Shacharito/Final-Project/docs/architecture/ARCHITECTURE_DIAGRAM.md

# Firmware Architecture Diagram

## Boot Sequence Flow (Robust)

```
┌─────────────────────────────────────────────────────────┐
│                    DEVICE POWERS ON                      │
└──────────────────────┬──────────────────────────────────┘
                       │
                       ▼
        ┌──────────────────────────────────┐
        │   Initialize Serial (460800 baud)│
        │   Display Startup Banner         │
        │   Increment boot counter         │
        └──────────────┬───────────────────┘
                       │
                       ▼
        ┌──────────────────────────────────┐
        │      WiFi Initialization         │
        │      [CRITICAL - REQUIRED]       │
        └──────────────┬───────────────────┘
                       │
          ┌────────────┴────────────┐
          │                         │
          ▼ (Success)              ▼ (Fail)
      ✅ Connected             ❌ Sleep Now!
          │                         │
          │                    Enter Deep Sleep
          │                    Retry on wake
          │
          ▼
        ┌──────────────────────────────────┐
        │    Hardware Initialization       │
        │    [IMPORTANT - NON-FATAL]       │
        │                                  │
        │  1. Try to init camera           │
        │  2. If fails: Log error          │
        │  3. Mark unavailable             │
        │  4. CONTINUE ANYWAY!             │
        └──────────────┬───────────────────┘
                       │
          ┌────────────┴────────────┐
          │                         │
    ✅ Camera Ready           ⚠️ Camera Failed
     (Inference works)    (Graceful degradation)
          │                         │
          └────────────┬────────────┘
                       │
                       ▼
        ┌──────────────────────────────────┐
        │     WebServer Initialization     │
        │     [ALWAYS WORKS]               │
        │                                  │
        │ Register endpoints:              │
        │  - /run (inference)              │
        │  - /image.jpg                    │
        │  - /get_config                   │
        │  - /set_config                   │
        │  - /sleep                        │
        │  - /health (NEW!)                │
        │  - /diagnose (NEW!)              │
        └──────────────┬───────────────────┘
                       │
                       ▼
        ┌──────────────────────────────────┐
        │      Display Boot Summary        │
        │      Show available endpoints    │
        │      Ready for requests          │
        └──────────────┬───────────────────┘
                       │
                       ▼
        ┌──────────────────────────────────┐
        │      Main Loop (Event-Driven)    │
        │      server.handleClient()       │
        │      Wait for HTTP requests      │
        └──────────────────────────────────┘
```

---

## Error Handling Architecture

```
┌────────────────────────────────────────────────────────┐
│              ERROR HANDLING STRATEGY                    │
└────────────────────────────────────────────────────────┘

LEVEL 1: CRITICAL (Must Succeed)
┌─────────────────────────────────────────────────────┐
│ WiFi Connection                                      │
│ ├─ Success: Continue to next step                  │
│ └─ Fail: Enter deep sleep immediately              │
│          Retry on next wakeup                       │
└─────────────────────────────────────────────────────┘

LEVEL 2: IMPORTANT (Report but Continue)
┌─────────────────────────────────────────────────────┐
│ Camera Initialization                               │
│ ├─ Success: Mark camera_initialized=true           │
│ ├─ Fail: Log error, Mark false, CONTINUE           │
│ │        Device stays online for diagnostics        │
│ └─ Inference requests return 503 error             │
│                                                      │
│ Image Capture                                       │
│ ├─ Success: Use for inference                      │
│ └─ Fail: Report error to client via API            │
│                                                      │
│ Inference Execution                                 │
│ ├─ Success: Return classification results          │
│ └─ Fail: Return 500 with error details             │
└─────────────────────────────────────────────────────┘

LEVEL 3: ADVISORY (Log Only)
┌─────────────────────────────────────────────────────┐
│ Memory Allocation                                    │
│ ├─ Success: Use allocated buffer                   │
│ └─ Fail: Log and return error to client            │
│                                                      │
│ Individual Sensor Errors                            │
│ ├─ Log error                                        │
│ └─ Continue operation                              │
└─────────────────────────────────────────────────────┘
```

---

## API Endpoint Architecture

```
┌──────────────────────────────────────────────────┐
│          HTTP SERVER (Port 80)                   │
└──────────────────────────────────────────────────┘
        │
        ├─────────────────────────────────────────────────┐
        │         INFERENCE ENDPOINTS                     │
        │                                                 │
        ├─→ GET /run                                      │
        │   └─ Run person detection                      │
        │      ├─ Check: camera_initialized?             │
        │      ├─ Try: Capture image                     │
        │      ├─ Try: Run model                         │
        │      └─ Return: Classification or error (503)  │
        │                                                 │
        ├─→ GET /image.jpg                              │
        │   └─ Return: Last JPEG (or 404)                │
        │
        └─────────────────────────────────────────────────┐
        │         CONFIGURATION ENDPOINTS                 │
        │                                                 │
        ├─→ GET /get_config                              │
        │   └─ Return: SSID, thresholds, boot count      │
        │                                                 │
        ├─→ POST /set_config?ssid=X&password=Y           │
        │   └─ Update: WiFi and inference settings       │
        │                                                 │
        ├─→ POST /sleep?duration=60                      │
        │   └─ Action: Enter deep sleep                  │
        │
        └─────────────────────────────────────────────────┐
        │      DIAGNOSTIC ENDPOINTS (NEW!)                │
        │                                                 │
        ├─→ GET /health                                  │
        │   └─ Return: { wifi: bool, camera: bool, ... } │
        │                                                 │
        ├─→ GET /diagnose                                │
        │   └─ Return: { device_info, hardware, memory } │
        │                                                 │
        └─ Both always work - even if camera missing!    │
```

---

## Device State Tracking

```
┌─────────────────────────────────────────────┐
│         DEVICE STATE STRUCTURE              │
├─────────────────────────────────────────────┤
│                                             │
│  wifi_connected: bool                       │
│  └─ Indicates if WiFi is active            │
│                                             │
│  camera_initialized: bool                  │
│  └─ Indicates if camera is ready           │
│                                             │
│  camera_init_error: uint32_t               │
│  └─ Error code if camera failed            │
│     0x20001 = I2C error                    │
│     0x20004 = XCLK error                   │
│     ...                                    │
│                                             │
│  last_capture_error: uint32_t              │
│  └─ Last frame capture error               │
│     1 = camera not initialized             │
│     2 = frame get failed                   │
│     3 = memory allocation failed           │
│                                             │
│  last_inference_ms: uint32_t               │
│  └─ Performance metric (milliseconds)      │
│                                             │
│  uptime_seconds: unsigned long             │
│  └─ Device uptime since boot               │
│                                             │
└─────────────────────────────────────────────┘
        │
        ├─ Updated by: Hardware init
        ├─ Updated by: Each capture attempt
        ├─ Updated by: Each inference
        └─ Reported by: /health, /diagnose
```

---

## Logging Architecture

```
PREFIX        WHERE           WHAT
────────────────────────────────────────────────────
[BOOT]        setup()         Startup information
[INIT]        setup()         Initialization sequence
[WIFI]        WiFi code       WiFi operations
[CAMERA]      Camera code     Camera initialization
[CAPTURE]     Capture code    Frame capture
[API]         Handlers        HTTP requests
[CONFIG]      SetConfig       Configuration changes
[SLEEP]       Sleep code      Sleep operations
[ERROR]       Everywhere      Error conditions

Example output:
[BOOT] Boot count: 5
[INIT] ▶ WiFi Initialization
[INIT] Connecting to 'Amit_wifi' ......
[INIT] ✓ WiFi connected! IP: 172.20.10.2
[INIT] ▶ Hardware Initialization
[INIT] Testing camera...
[CAMERA] ❌ FAILED: 0x20004
[CAMERA] Continuing without camera...
[INIT] ▶ Web Server Setup
[INIT] ✓ Web server started on port 80
```

---

## Recovery Paths

```
Scenario: Camera Not Connected
─────────────────────────────

Boot:
  1. Try camera init
  2. Fails with 0x20004 (XCLK error)
  3. Log error
  4. Mark camera_initialized = false
  5. Continue to webserver

Client detects issue:
  1. Try: GET /run
  2. Receive: 503 "Camera not initialized"
  3. Check: GET /diagnose
  4. See: camera_init_error: 0x20004
  5. Action: Connect camera

After connecting camera:
  1. Power cycle device (or reboot)
  2. Camera init succeeds
  3. Device ready for inference
  4. No code changes needed!

────────────────────────────────────────

Scenario: WiFi Connection Fails
─────────────────────────────

Boot:
  1. Try WiFi connection
  2. Fails after 20 attempts
  3. Log: "WiFi connection failed"
  4. No alternative: Enter deep sleep
  5. Device wakes after sleep_duration_sec
  6. Retries WiFi connection

Why no recovery? WiFi is critical!
  - No local network = can't reach device
  - No way to diagnose remotely
  - Deep sleep is the only option
```

---

## Code Structure Overview

```
firmware/main/main.ino
│
├─ SECTION 1: Configuration & State
│  ├─ WiFi credentials
│  ├─ Thresholds
│  └─ DeviceState struct (tracks what works)
│
├─ SECTION 2: Utility Functions
│  ├─ ei_malloc() - Safe memory allocation
│  ├─ getErrorMessage() - Human-readable errors
│  ├─ getUptimeSeconds() - System metric
│  └─ get_data() - Inference callback
│
├─ SECTION 3: Power Management
│  ├─ goToDeepSleep() - Safe shutdown
│  └─ getWakeupReasonText() - Wake reason
│
├─ SECTION 4: Hardware Init (FAULT TOLERANT)
│  ├─ initCamera() - Non-fatal failures
│  └─ captureImageForModel() - Safe capture
│
├─ SECTION 5: Web Server (ROBUST)
│  ├─ handleRunInference() - With error checks
│  ├─ handleGetImage() - Graceful not found
│  ├─ handleHealth() - Always works NEW!
│  ├─ handleDiagnose() - Always works NEW!
│  └─ ... other handlers ...
│
└─ SECTION 6: Main Runtime
   ├─ setup() - 6-step initialization
   └─ loop() - Event-driven server
```

---

## Next Steps Flowchart

```
                    START HERE
                        │
                        ▼
                ┌────────────────┐
                │ Power cycle    │
                │ device         │
                └────────┬───────┘
                         │
                         ▼
         ┌───────────────────────────────────┐
         │ Compile NEW firmware             │
         │ arduino-cli compile --fqbn ...   │
         └───────────────┬───────────────────┘
                         │
                         ▼
         ┌───────────────────────────────────┐
         │ Upload firmware                  │
         │ arduino-cli upload -p /dev/... │
         └───────────────┬───────────────────┘
                         │
                         ▼
         ┌───────────────────────────────────┐
         │ Test without camera               │
         │ curl /health                      │
         │ curl /diagnose                    │
         └───────────┬───────────────────────┘
                     │
      ┌──────────────┴──────────────┐
      │                             │
    ✅ YES                        ❌ NO
   (camera_ready: false)       (ERROR)
      │                             │
      ▼                             ▼
   ✅ SUCCESS!              Check error code
   Device works              Review connections
   with sensors              Try reboot
      │
      │ (When camera connected)
      ▼
   Power cycle device
   Camera auto-detected
   Ready for inference!
```

---

## Robustness Checklist

```
✅ Fault Tolerance
   ✓ Camera can be missing
   ✓ Device doesn't crash
   ✓ Errors are reported
   ✓ Can continue without sensors

✅ Error Handling  
   ✓ HTTP status codes correct
   ✓ Error details in response
   ✓ All paths tested
   ✓ No undefined behavior

✅ Diagnostics
   ✓ /health endpoint
   ✓ /diagnose endpoint
   ✓ Clear error codes
   ✓ Memory metrics

✅ Code Quality
   ✓ Organized into sections
   ✓ Clear logging
   ✓ Safe memory management
   ✓ Consistent patterns

✅ Documentation
   ✓ API reference
   ✓ Architecture guide
   ✓ Implementation summary
   ✓ Troubleshooting guide
```
