Shacharito/Final-Project/docs/SESSION_NOTES.md

# men_ai_model – Session Notes

> For project goals and status → see [ROADMAP.md](ROADMAP.md)
>
> This file records debug investigations and session-by-session technical notes.

---

## Session 2 — WiFi + Image Quality (June 11, 2026)

### What was accomplished
- Replaced serial image transfer with WiFi HTTP API (serial was corrupted by VirtualBox USB)
- Added `captureDisplayJpeg()`: grabs a **fresh 320×240 frame** at quality-60 after inference
  - Old display image: 96×96 quality-15 = **1.7 KB** (blocky thumbnail, useless)
  - New display image: 320×240 quality-60 = **8.3 KB** (real camera frame, ~5× larger)
- Python client (`men_ai_model.py`) polls HTTP `/run`, fetches `/image.jpg`, saves labeled JPEG
- Solved VM routing: bridged NIC `enp0s8` needs `sudo ip addr/route`; Python `_ensure_route()` auto-heals
- End-to-end working: Press Enter → ESP32 captures+infers → Python saves `YYYYMMDD_label_XX%.jpg`

### Detection result observed
| Sample | person % | no_person % | Inference |
|---|---|---|---|
| 20260611_173812 | **98.4%** | 1.6% | 148ms |

Only 1 sample taken. Need more captures in varied lighting/angles to judge real-world accuracy.

### Key insight
Photo quality is now much better visually, but the **model still crops to 96×96** — real-world accuracy is limited until the model is retrained on images from this exact camera setup. Next step: increase frame size to VGA so the 96×96 crop sees more context.

---

## Session 1 — Root Cause Analysis: Why the Classifier Wasn't Running (June 11, 2026)

---

## Root Cause Analysis — Why the Classifier Wasn't Running

### Context

The project downloads an Edge Impulse person-classifier model for the ESP32-S3 (GOOUUU cam board with 8MB OPI PSRAM). The sketch compiles and uploads without errors, the camera initializes fine, and frames are captured correctly. But every call to `run_classifier()` returned error **-3** (`EI_IMPULSE_TFLITE_ERROR`), meaning TFLite inference failed completely.

---

### Step 1 — First symptom: error -3 with no explanation

The sketch already had a `printEiError()` function that mapped -3 to `"TFLite or inference engine error"`, but gave no detail. We could see the board booting, camera working, and even `get_data` callbacks firing — but `run_classifier()` silently failed every time.

---

### Step 2 — Enabling hidden TFLite error strings

The Edge Impulse library has this in `micro_log.h`:

```cpp
#ifndef EON_COMPILER_RUN
#define TF_LITE_STRIP_ERROR_STRINGS   // ← silences ALL TFLite internal errors
#endif
```

Because `EON_COMPILER_RUN` is not defined (this is a standard TFLite Micro build), `MicroPrintf(...)` becomes a no-op — every internal TFLite error message is stripped out at compile time. This is why the only output was "AllocateTensors() failed" from the high-level wrapper, with no detail below it.

**Fix:** Comment out `TF_LITE_STRIP_ERROR_STRINGS` in `micro_log.h` to enable verbose TFLite logging.

---

### Step 3 — Finding the exact failure message

With error strings enabled, the board printed:

```
Failed to resize buffer. Requested: 258688, available 189916, missing: 68772
AllocateTensors() failed
```

This meant the TFLite Micro arena (memory workspace used to lay out all tensors and scratch buffers) was too small. The model needed **~259KB** inside the arena at peak, but only **~190KB** was available.

---

### Step 4 — Why the arena was too small

The Edge Impulse library defined the arena size in:
```
src/tflite-model/tflite_learn_1013165_3.h
```
as:
```cpp
const size_t tflite_learn_1013165_3_arena_size = 256403;
```

This value is generated by Edge Impulse's profiler — but it appears to have been underestimated for this specific chip/SDK version combination. The actual peak usage during `AllocateTensors()` was ~325–470KB.

Additionally, the default `ei_calloc()` in the library uses `MALLOC_CAP_DEFAULT`, which can allocate from internal RAM (~298KB free at boot) — but TFLite Micro's internal resizing can fail if the allocation pattern doesn't satisfy alignment or contiguity requirements.

---

### The Fixes (both required together)

#### Fix 1 — Force arena allocation into PSRAM

Added to `men_ai_model.ino` (overrides the weak library symbols):

```cpp
void *ei_malloc(size_t size) {
    return heap_caps_malloc(size, MALLOC_CAP_SPIRAM | MALLOC_CAP_8BIT);
}

void *ei_calloc(size_t nitems, size_t size) {
    return heap_caps_calloc(nitems, size, MALLOC_CAP_SPIRAM | MALLOC_CAP_8BIT);
}

void ei_free(void *ptr) {
    free(ptr);
}
```

The board has **8MB PSRAM** free — this guarantees the 700KB arena fits easily.

#### Fix 2 — Increase the arena size

In `~/Arduino/libraries/esp32_person_classifier_inferencing/src/tflite-model/tflite_learn_1013165_3.h`:

```cpp
// Before:
const size_t tflite_learn_1013165_3_arena_size = 256403;

// After:
const size_t tflite_learn_1013165_3_arena_size = 700000;
```

The `--clean` flag was needed when recompiling to force the cached `.o` files to be rebuilt with the new value.

---

### Result after fixes

```
Inference results:
  no_person   :  2.7%
  person      : 97.3%
  Inference time: 147 ms
```

The classifier runs correctly at ~147ms per frame (~7 fps equivalent) using the ESP32-S3's NN accelerator.

---

## What was done this session

### 1. Arduino IDE / arduino-cli setup
- Arduino IDE 2 was already installed as an AppImage at `~/arduino-ide.AppImage`.
- `arduino-cli` was **not** installed as a standalone tool — it was downloaded and placed at `~/.local/bin/arduino-cli` (v1.5.1).
- To use it in any new terminal session, run:
  ```bash
  export PATH="$HOME/.local/bin:$PATH"
  ```
  Or add that line permanently to `~/.bashrc`.

### 2. arduino-cli configuration
- Config file used: `~/.arduinoIDE/arduino-cli.yaml`
- ESP32 board URL already configured:
  ```
  https://raw.githubusercontent.com/espressif/arduino-esp32/gh-pages/package_esp32_index.json
  ```
- Installed cores:
  - `arduino:avr` 1.8.8
  - `esp32:esp32` 3.3.8 (latest available: 3.3.10)

### 3. Libraries
- `esp32_person_classifier_inferencing` 1.0.1 — already installed (Edge Impulse model)
- `object_detection_inferencing` 1.0.3 — already installed

### 4. Sketch compiled
- Sketch: `men_detection_model/men_ai_model/men_ai_model.ino`
- Board: **ESP32-S3** (GOOUUU ESP32-S3 CAM)
- FQBN used:
  ```
  esp32:esp32:esp32s3:PSRAM=opi,FlashSize=4M,PartitionScheme=huge_app,USBMode=hwcdc,UploadMode=default,CPUFreq=240
  ```
- Compile result: **OK** — 35% flash, 10% RAM

### 5. Sketch uploaded
- Board connected via USB through VirtualBox (forwarded as `/dev/ttyUSB0`)
- Upload command:
  ```bash
  export PATH="$HOME/.local/bin:$PATH"
  arduino-cli upload \
    --fqbn "esp32:esp32:esp32s3:PSRAM=opi,FlashSize=4M,PartitionScheme=huge_app,USBMode=hwcdc,UploadMode=default,CPUFreq=240" \
    --port /dev/ttyUSB0 \
    --config-file ~/.arduinoIDE/arduino-cli.yaml \
    "men_detection_model/men_ai_model"
  ```
- Upload result: **OK** — 1,107,120 bytes written, hard reset done.

---

## Next steps / To continue

### Run the Python listener
The Python script reads serial output (predictions + images) from the ESP32:
```bash
cd men_detection_model
python3 men_ai_model.py
```
Make sure `/dev/ttyUSB0` is available and you have permissions:
```bash
sudo usermod -aG dialout $USER   # then log out/in once
```

### To recompile & re-upload (quick reference)
```bash
export PATH="$HOME/.local/bin:$PATH"

# Compile
arduino-cli compile \
  --fqbn "esp32:esp32:esp32s3:PSRAM=opi,FlashSize=4M,PartitionScheme=huge_app,USBMode=hwcdc,UploadMode=default,CPUFreq=240" \
  --config-file ~/.arduinoIDE/arduino-cli.yaml \
  "men_detection_model/men_ai_model"

# Upload (after connecting board)
arduino-cli upload \
  --fqbn "esp32:esp32:esp32s3:PSRAM=opi,FlashSize=4M,PartitionScheme=huge_app,USBMode=hwcdc,UploadMode=default,CPUFreq=240" \
  --port /dev/ttyUSB0 \
  --config-file ~/.arduinoIDE/arduino-cli.yaml \
  "men_detection_model/men_ai_model"
```

### Optional: update ESP32 core to 3.3.10
```bash
export PATH="$HOME/.local/bin:$PATH"
arduino-cli core update-index --config-file ~/.arduinoIDE/arduino-cli.yaml
arduino-cli core upgrade esp32:esp32 --config-file ~/.arduinoIDE/arduino-cli.yaml
```
