Shacharito/Final-Project/Project Report/מצגת אמצע- 3335 (2).pptx

## פתיחה

- שם הפרויקט- זיהוי עצמים בשטח
- מס' הפרוייקט-3335
- מנחה- חזי ניסתאני
- סטודנטים- עמית שרביט ושחר וינברג
- מקום ביצוע- אוניברסיטת תל אביב
- אישור מנחה- חזי ניסתאני

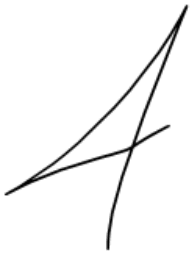
[picture p12: figure]

## נושא הפרויקט

- פיתוח מערכת עצמאית לזיהוי נוכחות בשטח פתוח
- פעילות באזור ללא תשתית חשמל ותקשורת קווית
- צריכת הספק נמוכה ויכולת פעולה ממושכת
  - זמן רצוי לעבודה בשטח- כחצי שנה
- דיוק גבוה
- אינטגרציה של רכיבי מדף חכמים

## דרישות מערכת

- אופן מימוש הפרויקט-אינטגרציה של רכיבי מדף חכמים
- דרישות הפרויקט:
  - זיהוי עצמים עד 30 מ'
  - אחוז זיהוי שווא- קטן מ 10%
  - עמידות בכל תנאי מזג האוויר
  - זמן עבודה בשטח- בהתאם לבדיקות חומרה

## דיאגרמת בלוקים

Field Unit

Battery DC/DC + Charger

WIFI Server

Control Unit

MCU

Computer

PIR Sensor

RADAR Sensor

LIDAR Sensor

Camera

## דיאגרמת בלוקים

- כלל הרכיבים- רכיבי מדף
- אינטגרציה
- אלגוריתמיקה- כדי לקבוע זיהוי

## תוצרי הפרויקט- עד כה

- מפרט דרישות מערכת
- תכן מעגלים ראשוני ושרטוט סכמות
- ביצוע סקר שוק ורכישת רכיבים

## סכמה חשמלית

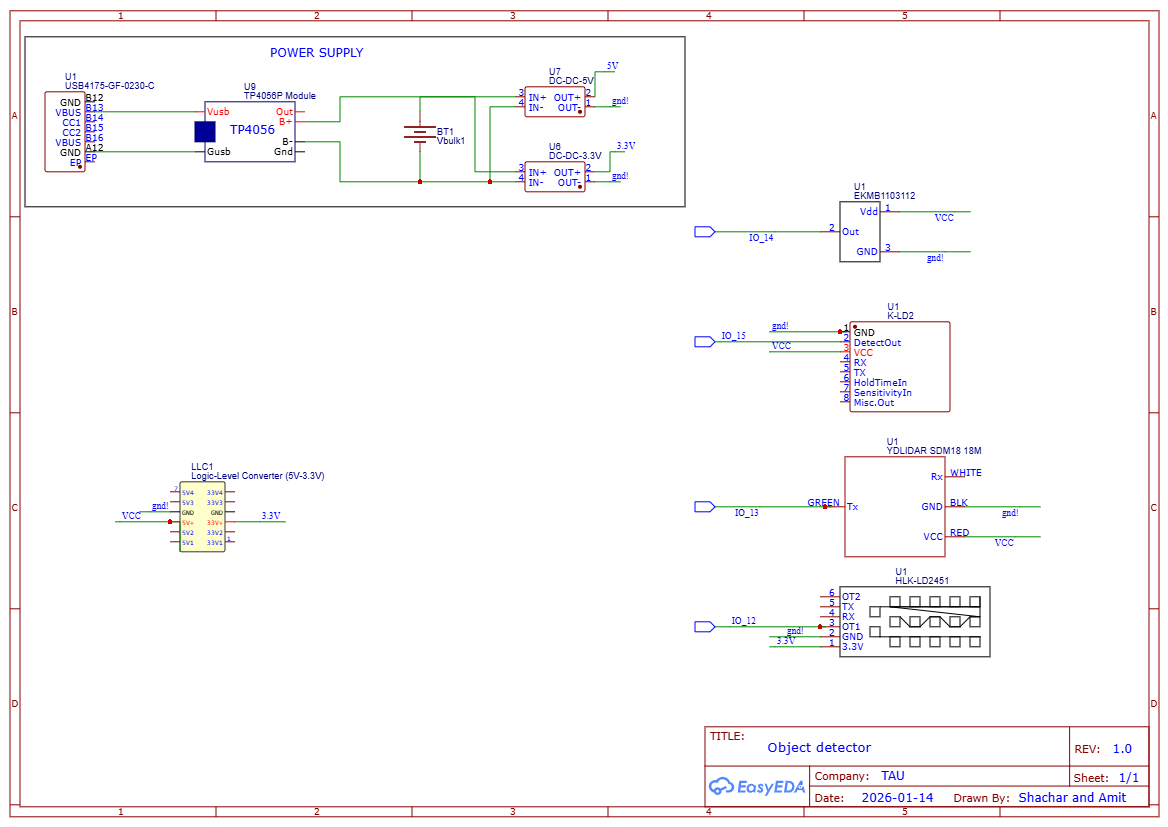
[picture p13: figure]

## סכמה חשמלית

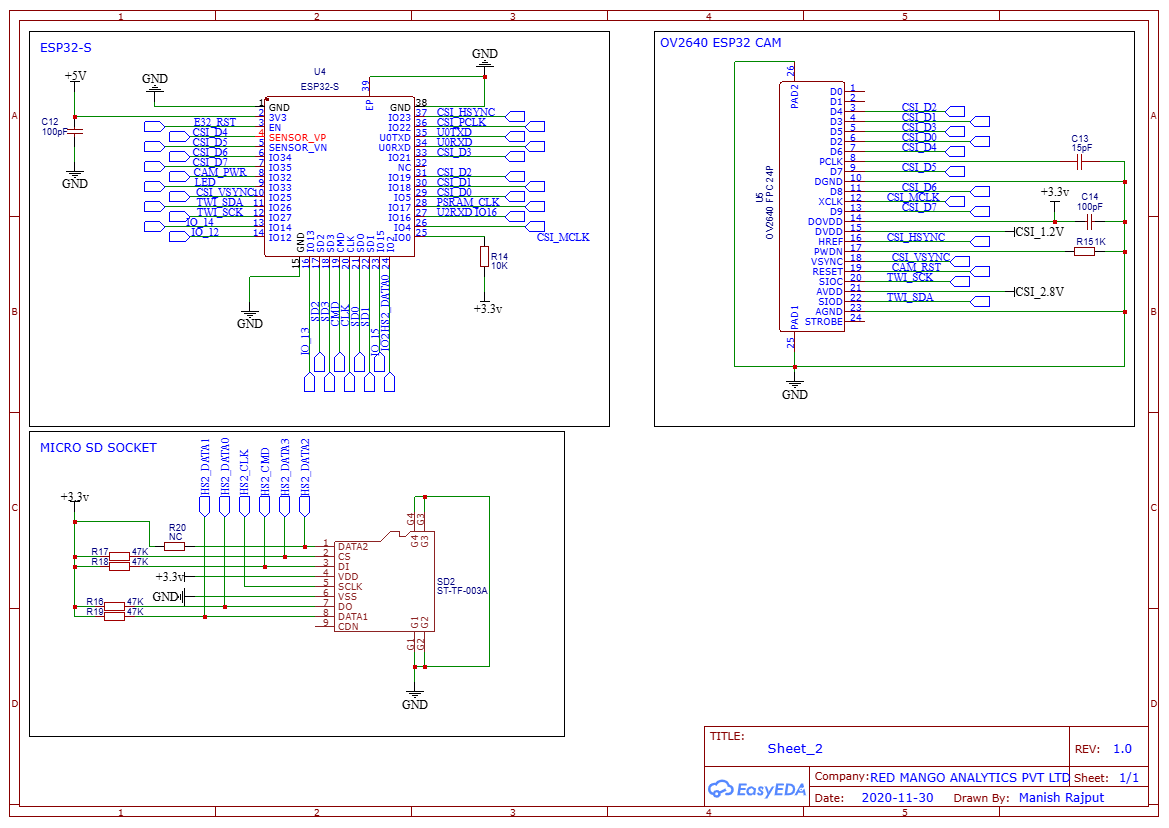
[picture p14: figure]

## סכמה חשמלית

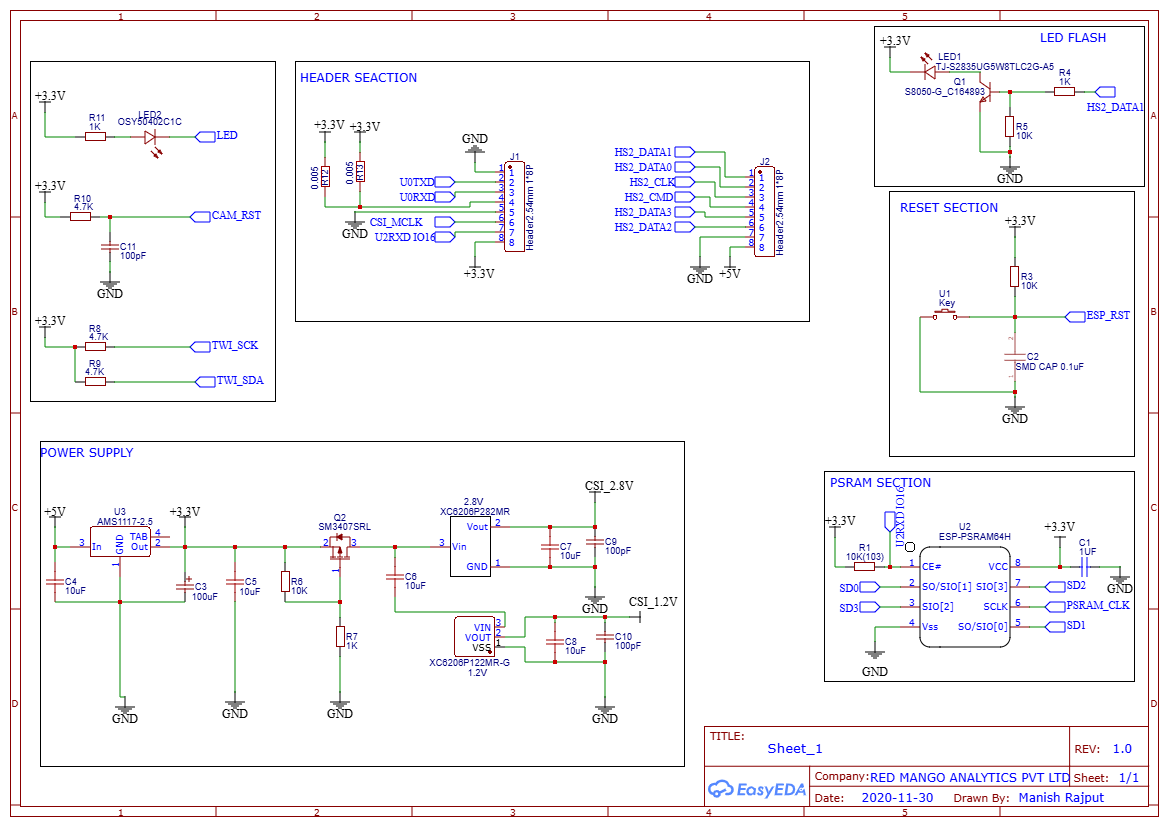
[picture p15: figure]
תמונה שמכילה טקסט, תרשים, תוכנית, מקביל תוכן בינה מלאכותית גנרטיבית עשוי להיות שגוי.

## רכש

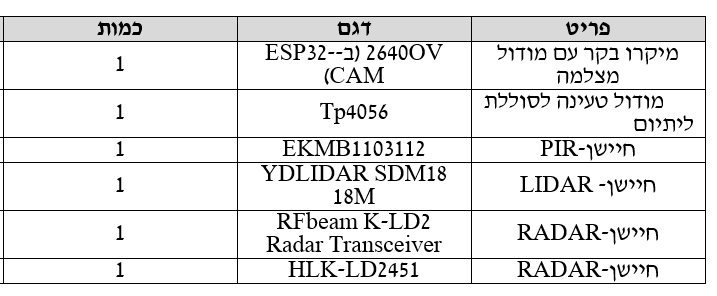
[picture p16: figure]
תמונה שמכילה טקסט, מספר, גופן, צילום מסך תוכן בינה מלאכותית גנרטיבית עשוי להיות שגוי.

## לו"ז מעודכן

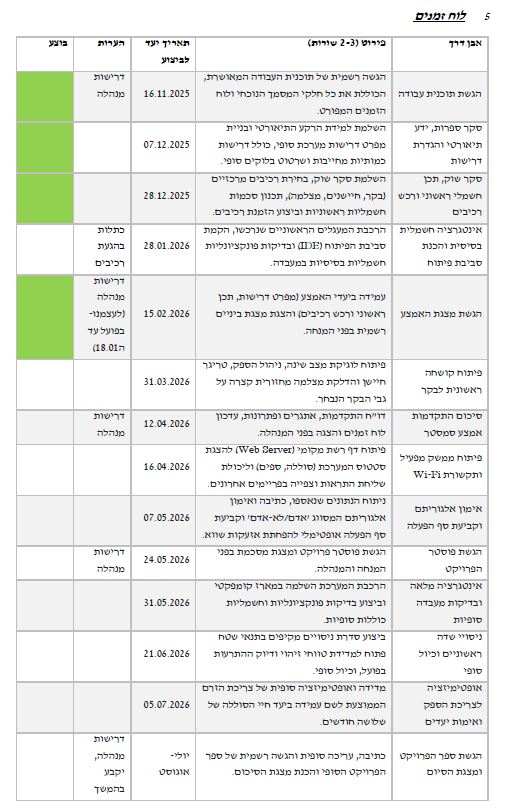
[picture p17: figure]
תמונה שמכילה טקסט, צילום מסך, מסמך, מספר תוכן בינה מלאכותית גנרטיבית עשוי להיות שגוי.
