Shacharito/Final-Project/Project Report/ריכוז נתונים לרכש (1).xlsx

Sheet: כלל הרכיבים
פריט | יצרן | דגם | עקרון פעולה | ממשק נתונים לבקר | ממשק בקרה | צריכת זרם | מצבי שינה | זמן אתחול | קישור למפרט
מיקרו בקר עם תקשורת אלחוטית | Espressif Systems | ESP32 | מתח עבודה טיפוסי 3.3V תדר מעבד עד 240MHz זיכרון פנימי כ-520KB SRAM | WiFi 802.11 b g n Bluetooth BLE UART SPI I2C I2S SDIO GPIO Ethernet MAC | תצורה מלאה דרך תוכנה ו-GPIO אין ממשק בקרה חיצוני ייעודי | מצב עבודה עם WiFi כ-160 עד 260mA מצב קליטה כ-80 עד 90mA Light Sleep כ-0.8mA Deep Sleep עשרות מיקרו אמפר | Active Modem Sleep Light Sleep Deep Sleep Hibernate כולל התעוררות ע"י GPIO טיימר או ULP | אתחול טיפוסי מאות מילישניות תלוי קוד ו-Flash | קישור (https://drive.google.com/drive/folders/1aaki_Vi4lMN0uCIrmu_6FagBYTGURlgb)
מצלמה | OmniVision | OV2640 (ב-ESP32-CAM) | מערך פיקסלים קולט אור → ADC פנימי → ISP → דחיסת JPEG → יציאה מקבילית | DVP מקבילי: D0–D7, VSYNC, HREF, PCLK | SCCB (I2C תואם) | צריכת הזרם של מודול ESP32-CAM בזמן עבודה היא בערך 180 עד 300 מילי-אמפר, ובמצב Deep Sleep כ-6 מילי-אמפר. לכן נדרש ניהול הספק אגרסיבי או ניתוק מתח כדי לאפשר זמן עבודה של חודשים על סוללה. | תומך Power-Down וניתוק מתח פשוט | 250–500 מילישניות, ולכן ניתן לנתק את המצלמה לחלוטין ולחבר אותה מחדש רק בעת אירוע בלי לפגוע בתפקוד המערכת.
מודול טעינה לסוללת ליתיום | SEamopar (מותג מסחרי של המודול) שבב: TP4056 (יצרן השבב: Top Power / NanJing Top Power ASIC) | TP4056 5V 1A Charger Board (Micro USB / USB-C) | מתח כניסה: 4.5V–5.5V מתח טעינה סופי: 4.2V ±1% זרם טעינה טיפוסי: עד 1A (תלוי נגד קונפיגורציה) | לא רלוונטי אין תקשורת דיגיטלית לבקר | לא רלוונטי אין ממשק תצורה לבקר |  | לא רלוונטי אין מצבי שינה לוגיים | לא רלוונטי אין זמן אתחול | אופציה 1-כללית אופציה 2- עלי אקספרס (https://www.alldatasheet.com/view.jsp?Searchword=TP4056)
טכנולוגיה | דגם | טווח זיהוי מקסימלי (אדם) | צריכת זרם (ממוצעת/Standby) | מתח עבודה | ממשק תקשורת (אנלוגי / דיגיטלי) | הערות | עקרון פעולה | אות יציאה | יתרונות | חסרונות | קישור למפרט | עלות
Passive IR | EKMB1103112 | 17m | 1µA | 2.3–4 V | Digital | ייתכן עבור זיהוי התרחשות זה יותר | מזהה שינויי קרינה אינפרה אדומה הנפלטת מגוף חם כמו אדם. בתוך החיישן יש אלמנט פירואלקטרי שמייצר מתח קטן כאשר יש שינוי בטמפרטורת הקרינה הנקלטת. עדשה פרנלית מחלקת את שדה הראייה לאזורים וכאשר אדם נע בין אזורים מתקבל שינוי אות. מודד שינוי דינמי בקרינת חום ולא טמפרטורה מוחלטת. זיהוי נוכחות בחדרים מערכות חיסכון באנרגיה אזעקות. | אות דיגיטלי שמציין זיהוי תנועה. | • צריכת הספק זעירה • פשוט למימוש • אמינות גבוהה לזיהוי נוכחות • מתאים למערכות סוללה ו IOT | • לא מזהה עצמים סטטיים • רגיש להפרעות תרמיות וסביבתיות • אין מידע על מרחק או מהירות | https://industrial.panasonic.com/cdbs/www-data/pdf/EWA0000/bltn_eng_ekmb110711_ast-ind-247373.pdf | $30.48 (https://www.mouser.co.il/ProductDetail/Panasonic-Industrial-Devices/EKMB1103112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)
Lidar | YDLIDAR SDM18 18M | 18m | 150mA | 3.3v | serial com, looks good | הודעה 1 | החיישן משדר פולסי לייזר קצרים ומודד את הזמן שלוקח לאור לחזור לאחר החזרה מהאובייקט. מתוך זמן המעוף מחושב המרחק בדיוק גבוה. מרחק מדויק לעצמים בקו הראייה. משמש לרובוטיקה ניווט אוטונומי מדידת מרחק מדויקת מערכות בטיחות. | דיגיטלי לרוב UART או ממשק סדרתי. | • דיוק גבוה מאוד במדידת מרחק • תגובה מהירה • מתאים למיפוי וזיהוי מכשולים • יציבות גבוהה | • רגיש לאבק ערפל ואור חזק • צריכת חשמל גבוהה יותר • מחיר גבוה יחסית • דורש קו ראייה ישיר |  | 31.9 (https://he.aliexpress.com/item/1005008574310936.html?curPageLogUid=3f1zL2kaIbas)
Radar | RFbeam K-LD7 Radar Transceiver | 15-30m | 20-60mA | 3.2-5 | digital |  | החיישן משדר גל רדיו רציף וקולט את ההחזר מהאובייקט. שינוי בתדר או פאזה של האות המוחזר מאפשר לזהות תנועה ומהירות באמצעות אפקט דופלר. מודד נוכחות תנועה ומהירות יחסית של אובייקטים. גילוי תנועה מערכות בטיחות בקרה תעשייתית חיישני נוכחות מתקדמים. | אות אנלוגי או דיגיטלי בהתאם לממשק. | • עובד גם דרך חומרים דקים כמו פלסטיק או גבס • לא מושפע מתאורה או טמפרטורה • טווח גדול יחסית • מתאים לזיהוי תנועה בתנאי חוץ | • רזולוציית מרחק נמוכה יחסית ללידאר • עלול לזהות תנועה לא רצויה • דורש סינון אותות | data (https://www.mouser.co.il/datasheet/3/6064/1/AF222E135543C32173A20E69393CBA10C54969FB1197A453312819F035623C2F.pdf) | 60-90 (https://www.mouser.co.il/ProductDetail/RFbeam/K-LD7-RFB-00H-01?qs=2wMNvWM5ZX55kEzEOvbacQ%3D%3D)
Radar | HLK-LD2451 | 100m | 107mA | 5 |  | הודעה 3 | החיישן משדר אות רדאר בתדר משתנה באופן רציף ומודד את ההפרש בין האות המשודר והמוחזר. מאפשר חישוב מרחק מהירות וזיהוי נוכחות גם בעצם סטטי. מרחק תנועה ונוכחות כולל עצמים שאינם זזים. מערכות נוכחות חכמות ניטור מרחב בטיחות תעשייתית ואוטומציה. | דיגיטלי לרוב UART. | • טווח גדול מאוד • מזהה גם עצמים סטטיים • עובד בכל תנאי תאורה ומזג אוויר • מתאים למערכות חכמות ומתקדמות | • רזולוציה מרחבית נמוכה מלידאר • דורש עיבוד אותות • רגיש להחזרות מרובות בסביבה מורכבת | data (https://www.laskakit.cz/user/related_files/hlk-ld2451_user_manual_v1-0.pdf) | 6 (https://he.aliexpress.com/i/1005007468760568.html)

Sheet: Power Tree
פריט |  |  |  |  | דגם | עקרון פעולה | ממשק נתונים לבקר | ממשק בקרה | צריכת זרם | מצבי שינה | זמן אתחול
מיקרו בקר עם תקשורת אלחוטית |  |  |  |  | ESP32 | מתח עבודה טיפוסי 3.3V תדר מעבד עד 240MHz זיכרון פנימי כ-520KB SRAM | WiFi 802.11 b g n Bluetooth BLE UART SPI I2C I2S SDIO GPIO Ethernet MAC | תצורה מלאה דרך תוכנה ו-GPIO אין ממשק בקרה חיצוני ייעודי | מצב עבודה עם WiFi כ-160 עד 260mA מצב קליטה כ-80 עד 90mA Light Sleep כ-0.8mA Deep Sleep עשרות מיקרו אמפר | Active Modem Sleep Light Sleep Deep Sleep Hibernate כולל התעוררות ע"י GPIO טיימר או ULP | אתחול טיפוסי מאות מילישניות תלוי קוד ו-Flash
מצלמה |  |  |  |  | OV2640 (ב-ESP32-CAM) | מערך פיקסלים קולט אור → ADC פנימי → ISP → דחיסת JPEG → יציאה מקבילית | DVP מקבילי: D0–D7, VSYNC, HREF, PCLK | SCCB (I2C תואם) | צריכת הזרם של מודול ESP32-CAM בזמן עבודה היא בערך 180 עד 300 מילי-אמפר, ובמצב Deep Sleep כ-6 מילי-אמפר. לכן נדרש ניהול הספק אגרסיבי או ניתוק מתח כדי לאפשר זמן עבודה של חודשים על סוללה. | תומך Power-Down וניתוק מתח פשוט | 250–500 מילישניות, ולכן ניתן לנתק את המצלמה לחלוטין ולחבר אותה מחדש רק בעת אירוע בלי לפגוע בתפקוד המערכת.
מודול טעינה לסוללת ליתיום |  |  |  |  | TP4056 5V 1A Charger Board (Micro USB / USB-C) | מתח כניסה: 4.5V–5.5V מתח טעינה סופי: 4.2V ±1% זרם טעינה טיפוסי: עד 1A (תלוי נגד קונפיגורציה) | לא רלוונטי אין תקשורת דיגיטלית לבקר | לא רלוונטי אין ממשק תצורה לבקר |  | לא רלוונטי אין מצבי שינה לוגיים | לא רלוונטי אין זמן אתחול
טכנולוגיה |  |  |  |  | טווח זיהוי מקסימלי (אדם) | צריכת זרם (ממוצעת/Standby) | מתח עבודה | ממשק תקשורת (אנלוגי / דיגיטלי) | הערות | עקרון פעולה | אות יציאה
Passive IR |  |  |  |  | 17m | 1µA | 2.3–4 V | Digital |  | מזהה שינויי קרינה אינפרה אדומה הנפלטת מגוף חם כמו אדם. בתוך החיישן יש אלמנט פירואלקטרי שמייצר מתח קטן כאשר יש שינוי בטמפרטורת הקרינה הנקלטת. עדשה פרנלית מחלקת את שדה הראייה לאזורים וכאשר אדם נע בין אזורים מתקבל שינוי אות. מודד שינוי דינמי בקרינת חום ולא טמפרטורה מוחלטת. זיהוי נוכחות בחדרים מערכות חיסכון באנרגיה אזעקות. | אות דיגיטלי שמציין זיהוי תנועה.
Lidar |  |  |  |  | 18m | 150mA | 3.3v | serial com, looks good |  | החיישן משדר פולסי לייזר קצרים ומודד את הזמן שלוקח לאור לחזור לאחר החזרה מהאובייקט. מתוך זמן המעוף מחושב המרחק בדיוק גבוה. מרחק מדויק לעצמים בקו הראייה. משמש לרובוטיקה ניווט אוטונומי מדידת מרחק מדויקת מערכות בטיחות. | דיגיטלי לרוב UART או ממשק סדרתי.
Radar |  |  |  |  | 15-30m | 20-60mA | 3.2-5 | digital |  | החיישן משדר גל רדיו רציף וקולט את ההחזר מהאובייקט. שינוי בתדר או פאזה של האות המוחזר מאפשר לזהות תנועה ומהירות באמצעות אפקט דופלר. מודד נוכחות תנועה ומהירות יחסית של אובייקטים. גילוי תנועה מערכות בטיחות בקרה תעשייתית חיישני נוכחות מתקדמים. | אות אנלוגי או דיגיטלי בהתאם לממשק.
Radar |  |  |  |  | 100m | 107mA | 5 |  |  | החיישן משדר אות רדאר בתדר משתנה באופן רציף ומודד את ההפרש בין האות המשודר והמוחזר. מאפשר חישוב מרחק מהירות וזיהוי נוכחות גם בעצם סטטי. מרחק תנועה ונוכחות כולל עצמים שאינם זזים. מערכות נוכחות חכמות ניטור מרחב בטיחות תעשייתית ואוטומציה. | דיגיטלי לרוב UART.
מדידות שלנו לאבטיפוס
רכיב | בדיקת חיות ותקינות ראשונית | Iin[ma] first test | VIN[v] | VOUT[v] | הערות/חוסרים כלליים
ESP32 |  |  | 5 |  | model AI
PIR |  | לפי מפרט, שמחה אומר שמתח נמוך מאוד אז לכתוב לפי מפרט | 3
HLK-LD2451 |  | 500 | 5 | 3
Battery Module |  |  | -

Sheet: רכש
פריט | דגם | כמות | לינק לרכש
מיקרו בקר עם תקשורת אלחוטית | ESP32 | 1
מצלמה | OV2640 (ב-ESP32-CAM) | 1 | קישור (https://www.aliexpress.com/p/tesla-landing/index.html?scenario=c_ppc_item_bridge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)
מודול טעינה לסוללת ליתיום |  | 1 | קישור (https://he.aliexpress.com/item/1005008223648808.html?src=google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)
Passive IR | EKMB1103112 | 1
Lidar | YDLIDAR SDM18 18M | 1 | קישור (https://he.aliexpress.com/item/1005007833871625.html?srcSns=sns_WhatsApp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)
Radar | RFbeam K-LD7 Radar Transceiver | 1
Radar | HLK-LD2451 | 1 | קישור (https://he.aliexpress.com/item/1005008300795641.html?srcSns=sns_WhatsApp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)

Sheet: חיישנים- מידע שאספנו
טכנולוגיה | דגם | טווח זיהוי מקסימלי (אדם) | צריכת זרם (ממוצעת/Standby) | מתח עבודה | ממשק תקשורת (אנלוגי / דיגיטלי) | הערות | לינק למפרט | עלות | התאמה
Passive IR | EKMB1103112 | 17m | 1µA | 2.3–4 V | Digital | ייתכן עבור זיהוי התרחשות זה יותר | https://industrial.panasonic.com/cdbs/www-data/pdf/EWA0000/bltn_eng_ekmb110711_ast-ind-247373.pdf | $30.48 (https://www.mouser.co.il/ProductDetail/Panasonic-Industrial-Devices/EKMB1103112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) | 1
Passive IR | Panasonic EKMB1304113K | 12 m | 6 µA | 2.3–4 V | Digital |  | Panasonic EKMB1304113K Datasheet (https://industrial.panasonic.com/cdbs/www-data/pdf/EWA0000/bltn_eng_ekmb130811_ast-ind-247396.pdf) | ~$16 (Mouser) | 3
Passive IR | Excelitas PYQ 1548 (DigiPyro, Quad) | תלוי עדשה (MID/Short) | ~3 µA | 1.8–3.6 V | Digital + Interrupt | ניתן לקנפג את הרגישות | Excelitas PYQ1548 Datasheet (https://www.excelitas.com/sites/default/files/assets/product/document/26069.pdf) | — | 2
Passive IR | Murata IRS‑D200ST00R1 | תלוי עדשה | ~8 µA | 1.8–3.3 V | Digital + Interrupt |  | Murata IRS‑D200ST00R1 Datasheet (https://pim.murata.com/en-us/pim/details/?partNum=IRS-D200ST00R1&displayChangeClass=productDetailPrint) | ~$4.75 (DigiKey) | 3
Passive IR | HC-SR501 | 7m | 65u | 3.3V | digital |  | data (https://www.4project.co.il/documents/doc_5896_5127.pdf) | 1 (https://he.aliexpress.com/item/1005006039243790.html?curPageLogUid=NGBCDyKujs16) | 3
Radar | MS72SF1 | 8m | 110mA | 2.5-3.3V |  | ניתן לקינפוג | data (https://store.minewsemi.com/wp-content/uploads/2024/03/MS72SF1_Datasheet_C_EN-1.pdf) | 20.66 (https://he.aliexpress.com/item/1005008494859042.html?curPageLogUid=KjtbixQnYUzL) | 3
Radar | TF-Luna | 8m |  |  |  | הודעה 2 |  | 18 (https://he.aliexpress.com/item/1005001552425264.html?curPageLogUid=za4bAisIuGX1) | 3
Lidar | YDLIDAR SDM18 18M | 18m | 150mA | 3.3v | serial com, looks good | הודעה 1 |  | 31.9 (https://he.aliexpress.com/item/1005008574310936.html?curPageLogUid=3f1zL2kaIbas) | 2
Radar | uRAD USB v1.2 | 40m | 170mA | 3.5-10 | USB | הנראה טוב | data (https://urad.es/wp-content/descargables/uRAD%20-%20Datasheet%20-%20USB%20v1.2%20-%20EN.pdf) | 200 (https://urad.es/en/product/urad-radar-raspberry-pi/) | 2
Radar | RFbeam K-LD7 Radar Transceiver | 15-30m | 20-60mA | 3.2-5 | digital |  | data (https://www.mouser.co.il/datasheet/3/6064/1/AF222E135543C32173A20E69393CBA10C54969FB1197A453312819F035623C2F.pdf) | 60-90 (https://www.mouser.co.il/ProductDetail/RFbeam/K-LD7-RFB-00H-01?qs=2wMNvWM5ZX55kEzEOvbacQ%3D%3D) | 1
Radar | HLK-LD2451 | 100m | 107mA | 5 |  | הודעה 3 | data (https://www.laskakit.cz/user/related_files/hlk-ld2451_user_manual_v1-0.pdf) | 6 (https://he.aliexpress.com/i/1005007468760568.html) | 1

Sheet: לא רלוונטי
טכנולוגיה | דגם | טווח זיהוי מקסימלי (אדם) | צריכת זרם (ממוצעת/Standby) | מתח עבודה | ממשק תקשורת (אנלוגי / דיגיטלי) | הערות | לינק למפרט | עלות | התאמה
Radar | TI IWRL6432 (57–64GHz, Low‑Power FMCW) | עד 25m | 2mA תומך idle and deep sleep | 1.8–3.3 V | UART, SPI, I²C, CAN‑FD |  | TI IWRL6432 Datasheet (https://www.ti.com/lit/gpn/iwrl6432) | 23 (https://www.mouser.co.il/new/texas-instruments/ti-iwrl6432-radar-sensors/) | 1
Radar | TI IWR6843 (60–64GHz, DSP) | עד 25m | 2mA תומך idle | 1.8–3.3 V | UART, SPI, CAN‑FD, LVDS |  | TI IWR6843 Datasheet + TI Design Guide (https://www.ti.com/lit/ds/symlink/iwr6843.pdf?ts=1766146469087) | 21.4$ | 2
Radar | A121 | 7-23m | (1-3mW) בממוצע ניתן לקנפג מצבים | 1.8–3.3 V |  | Water level measurement up to 23 meters with lens utilization. • Human presence detection up to 7 meters with lens-free utilization. | A121 Datasheet (https://www.digikey.co.il/he/products/detail/acconeer-ab/A121-001-T-R/17883300) | 16 (https://www.digikey.co.il/he/products/detail/acconeer-ab/A121-001-T-R/17883300) | 1
