Shacharito/Final-Project/docs/notes/FILE_INDEX.md

# 📚 Complete Documentation Index

## 🚀 START HERE
**→ [QUICK_START.md](QUICK_START.md)** (5 min read)
- 30-second overview
- 5-minute setup steps
- Common scenarios
- One-liner tests
- Troubleshooting quick fixes

---

## 📖 Documentation by Purpose

### For Implementation/Deployment
| Document | Purpose | Read Time |
|---|---|---|
| [QUICK_START.md](QUICK_START.md) | Set up firmware | 5 min |
| [IMPLEMENTATION_SUMMARY.md](IMPLEMENTATION_SUMMARY.md) | What changed | 10 min |
| [API_REFERENCE.md](API_REFERENCE.md) | How to use API | 15 min |

### For Understanding Architecture
| Document | Purpose | Read Time |
|---|---|---|
| [ARCHITECTURE_DIAGRAM.md](ARCHITECTURE_DIAGRAM.md) | Visual flowcharts | 15 min |
| [ROBUST_FIRMWARE_GUIDE.md](ROBUST_FIRMWARE_GUIDE.md) | Design details | 20 min |
| [PROJECT_COMPLETE.md](PROJECT_COMPLETE.md) | What was delivered | 10 min |

### For Troubleshooting
| Document | Purpose | Read Time |
|---|---|---|
| [ROOT_CAUSE_ANALYSIS.md](ROOT_CAUSE_ANALYSIS.md) | Original issue | 10 min |
| [HARDWARE_DIAGNOSTIC.md](HARDWARE_DIAGNOSTIC.md) | Hardware tests | 15 min |
| [API_REFERENCE.md](API_REFERENCE.md) | Error codes | 10 min |

---

## 📂 File Structure

```
Final-Project/
│
├─ 📋 DOCUMENTATION (New!)
│  ├─ QUICK_START.md ⭐ START HERE
│  ├─ API_REFERENCE.md
│  ├─ ROBUST_FIRMWARE_GUIDE.md
│  ├─ ARCHITECTURE_DIAGRAM.md
│  ├─ IMPLEMENTATION_SUMMARY.md
│  ├─ PROJECT_COMPLETE.md
│  ├─ ROOT_CAUSE_ANALYSIS.md
│  ├─ HARDWARE_DIAGNOSTIC.md (existing)
│  └─ FILE_INDEX.md (this file)
│
├─ 🔧 FIRMWARE
│  └─ firmware/
│     ├─ main/
│     │  ├─ main.ino ✅ UPDATED (Robust!)
│     │  └─ config.h (No changes)
│     ├─ diagnostic/
│     ├─ factory_test/
│     ├─ test_wifi/
│     ├─ test_webserver/
│     └─ test_combined/
│
├─ 🐍 PYTHON
│  └─ python/
│     └─ main_client.py
│
└─ 📊 DATA
   └─ (image folders, datasets, etc.)
```

---

## 🎯 Quick Navigation by Task

### "I want to deploy the firmware"
1. Read: [QUICK_START.md](QUICK_START.md)
2. Section: "5-Minute Setup"
3. Command: Power cycle, compile, upload

### "I want to understand what changed"
1. Read: [IMPLEMENTATION_SUMMARY.md](IMPLEMENTATION_SUMMARY.md)
2. Read: [ARCHITECTURE_DIAGRAM.md](ARCHITECTURE_DIAGRAM.md)
3. Review: Changed files in firmware/main/main.ino

### "I want to use the API"
1. Read: [API_REFERENCE.md](API_REFERENCE.md)
2. Section: "Endpoint Summary"
3. Copy: Python client examples

### "Device is showing errors"
1. Read: [QUICK_START.md](QUICK_START.md) - Section "Troubleshooting"
2. Check: [API_REFERENCE.md](API_REFERENCE.md) - Section "Error Codes"
3. Run: `/diagnose` endpoint for details

### "I want to understand the architecture"
1. View: [ARCHITECTURE_DIAGRAM.md](ARCHITECTURE_DIAGRAM.md)
2. Read: [ROBUST_FIRMWARE_GUIDE.md](ROBUST_FIRMWARE_GUIDE.md)
3. Deep dive: [PROJECT_COMPLETE.md](PROJECT_COMPLETE.md)

### "I need to troubleshoot hardware"
1. Check: [HARDWARE_DIAGNOSTIC.md](HARDWARE_DIAGNOSTIC.md)
2. Run: Diagnostic tests from checklist
3. Review: [ROOT_CAUSE_ANALYSIS.md](ROOT_CAUSE_ANALYSIS.md)

---

## 📋 What Each Document Contains

### QUICK_START.md
- Overview (30 seconds)
- Setup steps (5 minutes)
- Common scenarios
- API cheat sheet
- Error codes
- Python examples
- Success checklist

### API_REFERENCE.md
- Base URL
- Endpoint summary table
- Detailed documentation for each endpoint
- Request/response examples
- Error handling examples
- Python client code
- Status codes reference
- Testing workflow

### ROBUST_FIRMWARE_GUIDE.md
- Architecture overview
- 6 firmware sections explained
- Error handling strategy (3 levels)
- Testing scenarios
- Usage examples
- Monitoring tips
- Benefits list

### ARCHITECTURE_DIAGRAM.md
- Boot sequence flowchart
- Error handling tree
- API endpoint map
- State tracking structure
- Logging format guide
- Recovery paths
- Code structure overview

### IMPLEMENTATION_SUMMARY.md
- What was done
- File changes
- How sensors handled
- Testing workflow
- Key improvements
- Safety features
- Success indicators

### PROJECT_COMPLETE.md
- What you asked for
- What you got (checklist)
- Files delivered
- Sensor handling details
- New endpoints
- Deployment checklist
- Success indicators
- Key metrics

### ROOT_CAUSE_ANALYSIS.md
- Problem identification
- Systematic testing results
- Root cause explanation
- Recovery steps
- Summary table

### HARDWARE_DIAGNOSTIC.md
- Hardware checklist
- Diagnostic procedures
- Physical inspection steps
- Connection tests
- Recovery procedures

---

## 🔍 Document Relationships

```
QUICK_START.md (START)
    ├─→ Want to understand more? → ARCHITECTURE_DIAGRAM.md
    ├─→ Need API details? → API_REFERENCE.md
    └─→ Troubleshooting? → HARDWARE_DIAGNOSTIC.md

ARCHITECTURE_DIAGRAM.md
    ├─→ Details on implementation? → ROBUST_FIRMWARE_GUIDE.md
    ├─→ What changed? → IMPLEMENTATION_SUMMARY.md
    └─→ Complete overview? → PROJECT_COMPLETE.md

API_REFERENCE.md (For all API questions)
    ├─→ Error codes? → API_REFERENCE.md#Error-Codes-Reference
    ├─→ Python code? → API_REFERENCE.md#Python-Client-Example
    └─→ Testing? → QUICK_START.md#One-Liner-Tests

ROOT_CAUSE_ANALYSIS.md (Background/History)
    ├─→ What was the original bug? → This document
    └─→ How was it fixed? → IMPLEMENTATION_SUMMARY.md
```

---

## ⏱️ Reading Time Estimates

| Time | Content |
|---|---|
| 5 min | QUICK_START.md |
| 10 min | IMPLEMENTATION_SUMMARY.md or PROJECT_COMPLETE.md |
| 15 min | API_REFERENCE.md or ARCHITECTURE_DIAGRAM.md |
| 20 min | ROBUST_FIRMWARE_GUIDE.md |
| 10 min | ROOT_CAUSE_ANALYSIS.md or HARDWARE_DIAGNOSTIC.md |
| **70 min** | Read everything |

---

## ✅ Pre-Deployment Checklist

Before uploading firmware:

- [ ] Read QUICK_START.md (5 min)
- [ ] Understand changes in IMPLEMENTATION_SUMMARY.md (10 min)
- [ ] Power cycle device (1 min)
- [ ] Have FQBN ready for compilation
- [ ] Know USB port (/dev/ttyUSB0)

---

## 🆘 How to Find Answers

**Q: How do I deploy?**  
→ [QUICK_START.md](QUICK_START.md#5-minute-setup)

**Q: What are all the endpoints?**  
→ [API_REFERENCE.md](API_REFERENCE.md#endpoint-summary)

**Q: How do I use /diagnose?**  
→ [API_REFERENCE.md](API_REFERENCE.md#get-diagnose---full-diagnostics)

**Q: What changed in the firmware?**  
→ [IMPLEMENTATION_SUMMARY.md](IMPLEMENTATION_SUMMARY.md)

**Q: How are sensor errors handled?**  
→ [PROJECT_COMPLETE.md](PROJECT_COMPLETE.md#how-sensors-being-disconnected-are-handled)

**Q: What's the error code 0x20004?**  
→ [API_REFERENCE.md](API_REFERENCE.md#error-codes-reference)

**Q: How does the boot sequence work?**  
→ [ARCHITECTURE_DIAGRAM.md](ARCHITECTURE_DIAGRAM.md#boot-sequence-flow-robust)

**Q: Why was WebServer crashing?**  
→ [ROOT_CAUSE_ANALYSIS.md](ROOT_CAUSE_ANALYSIS.md)

**Q: Is my hardware working?**  
→ [HARDWARE_DIAGNOSTIC.md](HARDWARE_DIAGNOSTIC.md)

---

## 📊 Statistics

| Metric | Count |
|---|---|
| Documentation files created | 6 |
| Total documentation lines | 2000+ |
| Code sections in firmware | 6 |
| New API endpoints | 2 |
| Error handling levels | 3 |
| Test scenarios documented | 5+ |
| Code examples provided | 20+ |

---

## 🎯 Recommended Reading Order

### For Quick Start
1. QUICK_START.md (5 min)
2. Deploy!

### For Understanding
1. PROJECT_COMPLETE.md (10 min) - Overview
2. ARCHITECTURE_DIAGRAM.md (15 min) - Visual
3. API_REFERENCE.md (15 min) - How to use

### For Deep Dive
1. IMPLEMENTATION_SUMMARY.md (10 min) - What changed
2. ROBUST_FIRMWARE_GUIDE.md (20 min) - Architecture
3. ROOT_CAUSE_ANALYSIS.md (10 min) - Background

### For Troubleshooting
1. QUICK_START.md - Troubleshooting section
2. API_REFERENCE.md - Error codes
3. HARDWARE_DIAGNOSTIC.md - Tests

---

## 📝 Version History

| Date | What | File |
|---|---|---|
| Today | Robust firmware implemented | main.ino |
| Today | API documentation created | API_REFERENCE.md |
| Today | Architecture guide created | ARCHITECTURE_DIAGRAM.md |
| Today | Quick start guide created | QUICK_START.md |
| Today | Summary documentation | PROJECT_COMPLETE.md |

---

## 🚀 You're Ready!

Everything is documented. Everything is ready. Deploy with confidence!

**Next step:** Open [QUICK_START.md](QUICK_START.md) and follow the 5-minute setup.

---

**Questions?** Check the [relevant section above](#-how-to-find-answers)  
**Lost?** Start with [QUICK_START.md](QUICK_START.md)  
**Ready?** Open your terminal and deploy!
