Shacharito/Final-Project/Project Report/project_report_missing_items.xlsx

Sheet: רשימות
סטטוס | עדיפות | אחראי
לא התחיל | גבוהה | שחר
בתהליך | בינונית | עמית
הושלם | נמוכה | שחר ועמית
לא רלוונטי |  | מנחה
 |  | לא נקבע

Sheet: חוסרים לספר
רשימת חוסרים להשלמת ספר הפרויקט
פרויקט 3335 | עודכן בתאריך 11/06/2026
מספר | פרק בספר | מה חסר | מה צריך לעשות | תוצר נדרש | עדיפות | אחראי | סטטוס | מקור מידע | הערות
1 | כללי | סגירת מצב מערכת סופית | להחליט ולתעד איזה רכיבים נכנסים למימוש הסופי ואיזה לא | טבלת רכיבים סופית | גבוהה | שחר ועמית | בתהליך | שיחה נוכחית וגיטהאב | כרגע ידוע שרק שני חיישנים לא נכנסו, צריך לפרט שמות
2 | מימוש חומרה | טבלת רכיבים מלאה | להוציא מהקובץ רכש ומהסכמות רשימת רכיבים, תפקיד, מתח עבודה, ממשק וסטטוס | טבלת BOM לספר | גבוהה | שחר ועמית | לא התחיל | ריכוז נתונים לרכש וסכמות
3 | מימוש חומרה | תמונות של המערכת במציאות | לצלם את הבקר, החיישנים, מודול הטעינה, הסוללות והחיבורים | 6 עד 8 תמונות מוכנות לשילוב בספר | גבוהה | שחר ועמית | לא התחיל | צילום עצמי | חשוב לצלם באור טוב
4 | מימוש חומרה | תיאור סכמות חשמליות | להסביר כל בלוק בסכמה, הזנות, GPIO, חיישנים, מצלמה וטעינה | פסקאות הסבר לכל סכמה | בינונית | שחר ועמית | בתהליך | components.png ו ESP32_module.png
5 | מימוש תוכנה | קוד סופי מאוחד | ליצור תיקייה או קובץ final_system שמריץ את ה Flow הסופי | main סופי או תיקיית final_system | גבוהה | שחר | לא התחיל | GitHub | אפשר להשאיר מקום למודל AI כ Placeholder
6 | מימוש תוכנה | דיאגרמת Flow תוכנה | להכין תרשים זרימה מהשכמה ועד צילום ושליחה | תרשים Flow נקי לספר | גבוהה | שחר | לא התחיל | מבנה הקוד
7 | מימוש תוכנה | תיאור קבצי GitHub | לכתוב לכל תיקייה וקובץ מה התפקיד שלו | טבלת תיעוד קבצים | בינונית | שחר | לא התחיל | GitHub | קישור: https://github.com/Shacharito/Final-Project
8 | תוצאות ובדיקות | בדיקות חיישנים | לתעד עבור כל חיישן חיבור, GPIO, תנאי בדיקה ותוצאה | טבלת בדיקות חיישנים | גבוהה | שחר ועמית | לא התחיל | מעבדה
9 | תוצאות ובדיקות | מדידות זרם | למדוד זרם במצבי שינה, ערות, צילום, WiFi וחיישנים | טבלת זרמים וגרף צריכה | גבוהה | שחר ועמית | לא התחיל | ספק כוח ומד זרם | זה קריטי לפרק תוצאות
10 | תוצאות ובדיקות | ניסוי זיהוי אמפירי | לבצע ניסויים עם אדם, ללא אדם, תנועה לא רלוונטית וטווחים שונים | טבלת Accuracy, Miss, False Alarm | גבוהה | שחר ועמית | לא התחיל | ניסוי שטח או מעבדה | מומלץ לפחות 20 ניסיונות עם אדם ו 20 בלי
11 | תוצאות ובדיקות | בדיקת טווח זיהוי | לבדוק את המערכת בכמה מרחקים ולתעד הצלחה או כישלון | טבלת טווחים | גבוהה | שחר ועמית | לא התחיל | ניסוי שטח | קשור לדרישת 30 מטר
12 | תוצאות ובדיקות | בדיקת תקשורת WiFi | לתעד טווח תקשורת, זמן תגובה ויכולת קבלת סטטוס או תמונה | טבלת בדיקת WiFi | בינונית | שחר | לא התחיל | Web Server ו Python
13 | תוצאות ובדיקות | צילומי מסך | לצלם Serial Monitor, Web Server, Python client ותמונות שנשמרו | תיקיית תמונות תיעוד | בינונית | שחר | לא התחיל | מחשב
14 | תכנון וסימולציה | חישוב חיי סוללה | לחשב חיי סוללה לפי מדידות זרם ו Duty Cycle | טבלת חישוב וגרף | גבוהה | שחר ועמית | לא התחיל | מדידות זרם | אפשר להשתמש בנוסחה עם קיבולת mAh
15 | רקע תאורטי | מקורות טכניים | לאסוף Datasheets ומקורות ל ESP32 S3, OV2640, PIR, HLK, TP4056, Edge Impulse | רשימת References | גבוהה | עמית | לא התחיל | אתרי יצרן
16 | מסקנות | סיכום עמידה בדרישות | לסכם מה עמד בדרישות ומה נשאר חלקי לפי תוצאות המדידה | טבלת דרישה מול תוצאה | גבוהה | שחר ועמית | לא התחיל | תוצאות בדיקות
17 | נספחים | נספחי תמונות ותיעוד | להחליט אילו סכמות, תמונות וטבלאות ייכנסו כנספח ולא בגוף הספר | רשימת נספחים | נמוכה | שחר ועמית | לא התחיל | כל החומרים

Sheet: סיכום
סיכום מצב השלמת ספר הפרויקט
מדד | ערך |  | עדיפות | כמות
סהכ משימות | 17 |  | גבוהה | 12
הושלם | 0 |  | בינונית | 4
בתהליך | 2 |  | נמוכה | 1
לא התחיל | 15
אחוז השלמה | 0%
המלצת סדר עבודה קרובה
שלב | פעולה | למה זה חשוב | תוצר
1 | לסגור רשימת רכיבים סופית | בלי זה קשה לכתוב את פרק החומרה | טבלת רכיבים
2 | ליצור קוד סופי או תיקיית final_system | בספר צריך לתאר מימוש ברור | קוד מרכזי
3 | למדוד זרמים | נדרש לפרק תוצאות ולחישוב סוללה | טבלת זרמים
4 | לבצע ניסוי זיהוי | נדרש להוכחת דרישות הדיוק | טבלת הצלחה וכישלון
5 | לצלם את המערכת | נדרש לפרק המימוש | תמונות לספר
6 | לאסוף מקורות | נדרש לפרק References | רשימת קישורים

Sheet: בדיקות נדרשות
בדיקות ומדידות שצריך להשלים
מספר | בדיקה | מטרה | ציוד נדרש | מדדים לתיעוד | תוצאה | סטטוס | הערות
1 | Deep Sleep | מדידת צריכת זרם במצב שינה | ספק כוח או מד זרם | זרם mA או uA |  | לא התחיל
2 | Idle | מדידת צריכת זרם כשהבקר ער | ספק כוח או מד זרם | זרם mA |  | לא התחיל
3 | Camera Capture | בדיקת צריכת זרם בזמן צילום | ESP32 ומד זרם | זרם שיא וזמן צילום |  | לא התחיל
4 | WiFi Active | בדיקת זרם וזמן תגובה בתקשורת | Web Server ומד זרם | זרם, זמן תגובה, הצלחה |  | לא התחיל
5 | PIR Trigger | בדיקת הפעלת צילום מטריגר | PIR, ESP32, Serial Monitor | מספר ניסיונות, הצלחות, פספוסים |  | לא התחיל
6 | HLK LD2451 | בדיקת זיהוי נוכחות או תנועה | חיישן, ESP32, Serial Monitor | זיהוי, מרחק, יציבות |  | לא התחיל
7 | ניסוי אדם מול לא אדם | חישוב דיוק וזיהוי שווא | מערכת מלאה | TP, FP, TN, FN, אחוזי הצלחה |  | לא התחיל | מומלץ לפחות 40 ניסיונות
8 | טווח זיהוי | בדיקה מול דרישת עד 30 מטר | מערכת מלאה ושטח פתוח | מרחק, הצלחה, פספוס |  | לא התחיל
9 | שמירת תמונה | לוודא שהתמונה נשמרת במחשב | Python client או WiFi | שם קובץ, איכות תמונה |  | לא התחיל

Sheet: רכיבים ומקורות
רכיבים ומקורות שצריך להשלים
רכיב או נושא | נכנס למערכת | תפקיד | מידע חסר | מקור נדרש | קישור | סטטוס | הערות
ESP32 S3 CAM | כן | בקר ראשי ומצלמה | דגם מדויק, מתח, GPIO, צריכת זרם | Datasheet או User Guide |  | לא התחיל
OV2640 | כן | מצלמה | רזולוציה, ממשק, צריכת זרם | Datasheet |  | לא התחיל
PIR | כן | טריגר תנועה | דגם מדויק, טווח, מתח, זרם | Datasheet |  | לא התחיל
HLK LD2451 | כן | חיישן נוכחות או תנועה | ממשק, מתח, זרם, טווח | Datasheet |  | לא התחיל
K LD2 | צריך החלטה | רדאר | האם נכנס לספר ומה הסטטוס | Datasheet |  | לא התחיל
YDLIDAR SDM18 | צריך החלטה | LIDAR | האם נכנס לספר ומה הסטטוס | Datasheet |  | לא התחיל
HLK LD2410C | לא | חיישן שנבדק | להסביר בקצרה למה לא נכנס | Datasheet אם מוזכר |  | לא התחיל
TP4056 | כן | מודול טעינה | זרם טעינה, מתח כניסה, הגנות | Datasheet |  | לא התחיל
18650 Battery Shield | כן | אספקת מתח | קיבולת סוללה, יציאה, זרם מקסימלי | Datasheet או עמוד מוצר |  | לא התחיל
Edge Impulse | חלקי | מודל AI | תיאור שימוש, סטטוס, מגבלות | Documentation |  | לא התחיל

Sheet: GitHub וקוד
סידור GitHub וקוד לקראת ספר הפרויקט
קישור GitHub | https://github.com/Shacharito/Final-Project
מטרה | לייצר תיעוד ברור של הקוד והקבצים עבור פרק Project Documentation
משימה | פירוט | תוצר | עדיפות | אחראי | סטטוס | הערות
יצירת תיקיית final_system | לרכז את הקוד שמייצג את ה Flow הסופי | תיקייה בגיטהאב | גבוהה | שחר | לא התחיל
עדכון README | להוסיף הסבר על מבנה התיקיות, הרצה ודרישות | README מסודר | גבוהה | שחר | לא התחיל
תיעוד תיקיות קיימות | להסביר flow, sensors, sleep mode, web server, men detection model | טבלת קבצים לספר | בינונית | שחר | לא התחיל
הוספת תמונות תיעוד | להעלות לתיקייה docs/images תמונות מערכת ותוצאות | תיקיית תמונות | בינונית | שחר ועמית | לא התחיל
תיוג גרסה | ליצור commit מסודר לגרסת ההגשה | commit או release | נמוכה | שחר | לא התחיל
