Shacharito/Final-Project/docs/components_power.txt

ESP32:
VCC = 5 V
Current = 0.7 A

Sensors:
Grove- Digital PIR:
VCC = 5 V
Curren = 00.05 A
