Shacharito/Final-Project/docs/setup_hardware.jpg

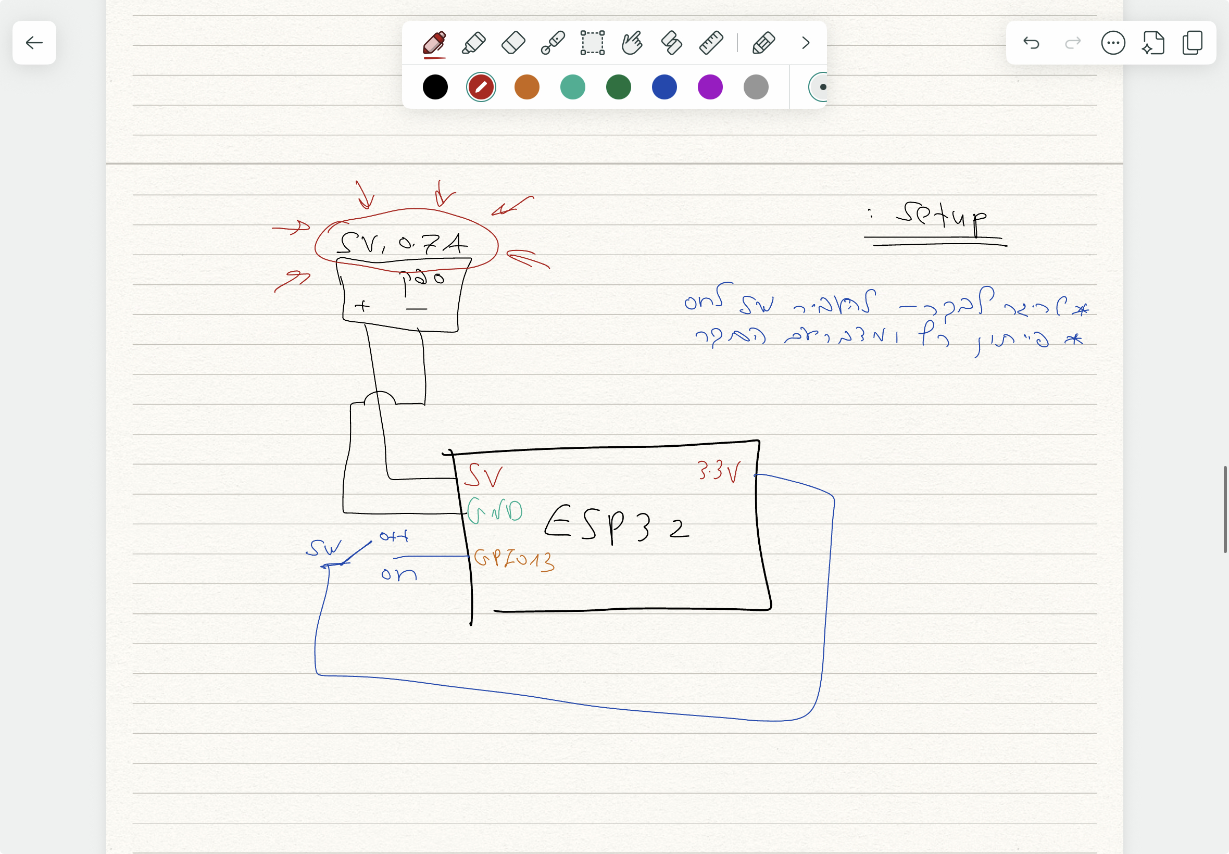
docs/setup_hardware.jpg
