Shacharito/Final-Project/(commit log)

2026-05-12 #ESP32 and Python Code
2026-05-12 #sensors folder
2026-05-19 Add working ESP32 WiFi web server and Python client
2026-05-19 t commit -m "Add ESP32 deep sleep wakeup test with WiFi web server"
2026-05-19 Add camera capture after deep sleep wakeup
2026-05-26 Add ESP32 camera capture after deep sleep trigger
2026-06-11 add Project Report
    [project_report_missing_items.xlsx, ריכוז נתונים לרכש (1).xlsx]
2026-06-11 Rename folder, add WiFi HTTP API firmware and Python client
    - Renamed 'men detection model/' → 'men_detection_model/' (remove spaces)
    - men_ai_model.ino: WiFi HTTP server, Edge Impulse inference, 320x240 display JPEG
    - Fixed TFLite arena error (-3): arena 256KB → 700KB in PSRAM
    - PSRAM overrides for ei_malloc/calloc
    - Endpoints: /run /capture /image.jpg /info
    - men_ai_model.py: Python client, auto-route healing, saves labeled JPEGs
    - FIRMWARE_DESIGN.md: API reference, compile commands, library fix table
    - ROADMAP.md: project goals, status, improvement roadmap, session log
    - .gitignore: exclude auto-generated captured_images/*.jpg
    [capture.py, capturing.ino, men_ai_model.ino]
2026-06-11 Repo cleanup: remove garbage, fix folder names
    Deleted:
    - main.ino (empty stub, only had #include sensors.ino)
    - All .idea/ PyCharm metadata folders
    - 4 old object-detection Edge Impulse zips (~26MB freed)
    - men detection model/ (old spaced copy, superseded by men_detection_model/)
    - 23 test JPEGs mistakenly committed (flow/ and sleep_mode/)
    Renamed (spaces → underscores):
    - 'sleep mode/' → sleep_mode/
    - 'web server/' → web_server/
    Simplified:
    - sensors/Generic Sensor Test/sensors/ → sensors/ (flattened double-nesting)
    .gitignore:
    - **/captured_images/*.jpg (all runtime images, all modules)
    - **/.idea/ (all PyCharm metadata)
    [camera_mode.ino, main.ino, men_ai_model.ino, sensors.ino, sleep_mode.ino]
2026-06-11 Restructure repo into logical modules
    New layout:
    docs/ - ROADMAP.md, FIRMWARE_DESIGN.md, SESSION_NOTES.md,
    components_power.txt, setup_hardware.jpg
    firmware/ - all .ino sketches by function
    men_ai_model/, sleep_mode/, camera_mode/,
    flow/, web_server/, sensors/
    python/ - all Python clients
    person_detector.py, sleep_client.py, camera_client.py,
    web_client.py, sensors_client.py, flow_client.py
    training/ - Edge Impulse model zip, dataset/, capturing scripts
    Project Report/ - academic docs (unchanged)
    Also: fixed compile path in FIRMWARE_DESIGN.md to firmware/men_ai_model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
    [camera_mode.ino, capture.py, capturing.ino, men_ai_model.ino, sensors.ino, sensors_client.py, sleep_mode.ino]
2026-06-18 new work
    [partitions.csv]
